popliosemigod/RoboSumo/version.h

// =====================================================================
//  ROBO SUMO - version.h
//  A versao aqui deve casar com a tag do git, senao a placa mente sobre
//  qual firmware esta rodando.
// =====================================================================
#pragma once

#define FW_VERSION "4.0.0"
