popliosemigod/RoboSumo/(commit log)

2026-09-02 chore(repo): estrutura de projeto, convencoes de commit e CI
    Define o esqueleto que o time usa em todos os firmwares: Conventional Commits validados por pre-commit, versionamento por commitizen com a versao refletida em version.h, e um workflow que compila o firmware a cada push e publica o .bin para gravacao por OTA.
    Remove o arquivo placeholder criado junto com o repositorio.
2026-09-02 chore(build): configura PlatformIO mantendo o layout da Arduino IDE
    src_dir aponta para a raiz, entao os dois toolchains compilam a mesma pasta sem duplicar arquivo. A porta serial fica em autodeteccao porque a placa troca de COM ao reconectar.
2026-09-02 feat(config): pinout do ESP32, estados, modos e telemetria
    Pinos escolhidos em blocos fisicamente consecutivos no header da DevKit, para o chicote de cada subsistema sair de pinos vizinhos. Leitura analogica toda no ADC1, porque o ADC2 nao funciona com Wi-Fi ligado.
2026-09-02 feat(core): distribui as tasks entre os dois nucleos do ESP32
    Nucleo 1 fica com o tempo real (guarda de borda prio 6, controle a 200 Hz, leitura dos olhos). Nucleo 0 fica com Wi-Fi, OLED e buzzer. Assim um pedido HTTP travado nao consegue atrasar o freio na borda.
    [RoboSumo.ino]
2026-09-02 feat(motors): duas DRV8833 com os canais em paralelo, uma por lado
    IN1/IN2 comandam OUT1/OUT2 para o par esquerdo e IN3/IN4 comandam OUT3/OUT4 para o direito. Paralelar entrada com saida dobra a corrente do canal (1,5 A viram ~3 A), o que importa porque os dois motores de um lado dividem o mesmo par de saidas. Decaimento lento para ter torque em baixa rotacao.
2026-09-02 feat(sensors): olhos VL53L0X em barramento I2C dedicado
    Os dois modulos nascem no mesmo endereco 0x29, entao o boot liga um de cada vez pelo XSHUT e reendereca o primeiro para 0x30. Presenca e validada lendo o registrador 0xC0 (deve valer 0xEE, Tab. 4 da datasheet) porque o init da biblioteca consegue dar certo falando com o vazio. Barramento separado do OLED: um quadro do display ocupa a linha por ~25 ms e atrasaria a leitura durante a investida.
2026-09-02 feat(brain): maquina de estados com confirmacao anti-ruido do alvo
    Entre ver algo e investir existe o estado TRAVANDO: exige N leituras validas consecutivas e salto menor que jumpCm entre elas. Um eco espurio isolado nunca vira investida.
2026-09-02 feat(face): carinha animada no OLED com expressao por estado
    Olhos desenhados por primitiva grafica, nao por bitmap, para variarem de forma continua. Enum usa prefixo EX_ porque F_LOCK colide com uma macro de fcntl.h e quebrava a compilacao inteira do arquivo.
2026-09-02 feat(sound): tocador RTTTL nao bloqueante no buzzer
    Melodias de dominio publico (Wagner, Rossini, Bizet, Beethoven) mais composicoes proprias. Nao bloqueante porque a musica nao pode roubar tempo da malha de controle.
2026-09-02 feat(web): AP aberto, portal cativo, API JSON e gravacao OTA
    Rede ROBO_SUMO sem senha em 192.168.4.1, com DNS respondendo tudo para o mesmo IP - qualquer endereco digitado cai no painel. softAP antes de softAPConfig, que e a ordem documentada pela Espressif, e modem-sleep desligado porque atrasa beacon e derruba cliente. A partir da primeira gravacao o firmware se atualiza sozinho por OTA, sem PC.
2026-09-02 feat(web): painel de controle embarcado, sem CDN nem internet
    HTML, CSS e JS inteiros em PROGMEM porque a placa serve a pagina offline. Radar dos dois olhos, grafico de PWM e PID, sliders que valem na hora, calibracao do IR e pilotagem manual com watchdog de 700 ms.
2026-09-02 test(diag): painel de bancada no PC lendo a serial
    Le a linha #D chave=valor e mostra o estado de cada componente com verde/vermelho. Funciona sem Wi-Fi, que e justamente quando se precisa dele. Distingue 'barramento vazio' de 'responde mas nao subiu', e sinaliza modulo sem alimentacao em vez de reportar zona segura.
2026-09-02 docs(schematic): esquematico eletrico, pinout e geometria dos sensores
    Cinco folhas: ligacoes de sinal, arvore de alimentacao com terra unico, caminho critico do IR ate o freio, maquina de estados e vista superior do chassi.
2026-09-02 docs: guia de montagem, calibracao e diagnostico pela serial
    Inclui como ler o autoteste do boot, que separa problema de fiacao de problema de calibracao.
2026-09-02 chore(repo): ignora o caderno de sessao CONTEXTO.md
    Notas de bancada, pendencias e armadilhas ja encontradas. Muda a cada sessao e nao interessa a quem clona o repositorio, entao fica fora do git.
2026-09-04 feat: firmware do robo sumo em ESP32 com painel web
    Estado que ja rodou na placa: maquina de estados com contagem, busca,
    travamento anti-ruido, investida com PID e guarda de borda por interrupcao,
    distribuidos em tasks do FreeRTOS entre os dois nucleos. Painel web servido
    pelo proprio AP, calibracao guiada do IR e um conjunto de instrumentos de
    bancada na serial (autoteste, sonda eletrica das linhas I2C, exame dos olhos,
    monitores de 20 Hz e rajada de 1 kHz).
2026-09-04 feat(nano): porte bruto do firmware para Arduino Nano
    Regressao proposital de controlador, para separar problema de fiacao de
    problema de placa mantendo todos os perifericos.
    O ATmega328P impoe quatro mudancas de desenho que estao documentadas no
    codigo e no README da pasta: um unico barramento I2C (OLED divide a linha
    com os olhos, e o desenho e suspenso durante ataque e borda), timers
    compartilhados (PWM cai para 976/490 Hz e tone fica sozinho no Timer2),
    loop unico sem RTOS (a guarda de borda vira interrupcao mais teste no topo
    do loop) e logica de 5 V, que inverte a recomendacao de alimentacao do
    VL53L0X em relacao ao ESP32.
    O OLED nasce desligado por medida: com ele o flash vai a 92,9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
2026-09-04 fix(nano): assume modulo IR de tres fios, sem saida analogica
    Os modulos em uso tem VCC, GND e OUT - nao existe AO. O padrao irSource
    passa a ser 0 (so o pino digital) e a leitura analogica deixa de rodar
    quando ela nao esta selecionada: ler pino solto a 200 Hz so produz numero
    inventado, que foi justamente o que atrapalhou o diagnostico na placa
    anterior.
    Com isso o limiar sai do software e passa a ser o trimpot do modulo.
    Acrescenta a tecla 'p', que imprime o estado dos dois OUT por 60 s para
    ajustar o trimpot olhando o serial, e documenta o procedimento.
    A0 e A1 ficam livres.
2026-09-04 docs(nano): corrige numeracao da secao do modulo IR
    A secao do modulo de tres fios estava numerada 2.1 mas fica dentro da
    secao 1 (pinout), antes da secao 2.
2026-09-04 feat(nano): confirma identidade do VL53L0X pelos registradores de modelo
    O modulo em uso e um CJMCU-53L0X V2 (VCC/GND/SCL/SDA/GPIO1/XSHUT). A
    varredura I2C responde "alguem respondeu em 0x29", mas nao responde se
    esse alguem e mesmo um VL53L0X - modulo trocado, endereco coincidente de
    outro periferico e sensor morto que ainda da ACK aparecem todos iguais.
    Acrescenta a tecla 'i': le os tres registradores de identidade da Tab. 4
    da datasheet (0xC0=0xEE, 0xC1=0xAA, 0xC2=0x10), que existem desde o reset
    e nunca mudam, e diz se confere.
    Documenta tambem o teste de tensao a fazer ANTES de ligar o modulo no
    Nano: com o modulo alimentado sozinho em 5 V, medir SDA contra o GND.
    Perto de 5 V ha conv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
2026-09-04 fix(nano): protege o sensor de 3,3 V e instrumenta o barramento I2C
    O Nano fala em 5 V e o VL53L0X aguenta 3,6 V (Tab. 6). SDA e SCL nunca
    foram o risco - sao dreno aberto, o TWI so puxa para baixo. O risco real
    estava no XSHUT, que era dirigido em push-pull: dezenas de mA de 5 V
    contra o diodo de protecao do sensor. Agora XSHUT e dreno aberto (BAIXO
    para desligar, SOLTO para ligar) e os pull-up internos da Wire, que vao
    para 5 V, sao desligados logo apos o Wire.begin().
    Medido depois da correcao: 3,5 V em repouso nas duas linhas.
    Instrumentos novos, porque o barramento responde em 0x28 e 0x38 em vez
    de 0x29 e 0x3C e as hipoteses pediam medida, nao palpite:
    - u: le o nivel de repouso de A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
2026-09-04 feat(nano): mede o VCC e o GND do modulo pelas entradas A6 e A7
    Modulo sem VDD se alimenta pelos diodos de protecao das linhas de I2C e
    da ACK assim mesmo - foi o que apareceu na bancada, com 0x28 e 0x38
    respondendo ate com XSHUT em BAIXO, condicao em que um VL53L0X
    alimentado esta em standby e nao pode dar ACK nenhum.
    De dentro do barramento essa pergunta nao se responde. A6 e A7 sao
    entradas so analogicas e estavam livres: um jumper do VCC do modulo ate
    A6 e outro do GND ate A7 poem a medida na tecla k. A conta usa VREF de
    4,7 V, que e o AVcc real no USB, em vez dos 5,0 V nominais.
2026-09-04 docs(nano): registra A6 e A7 como sondas de tensao no pinout
    O pinout mandava consultar a secao 1.1 para A0/A1 e dizia que A6 e A7
    estavam livres. A0 e A1 nunca vao receber nada, porque o modulo IR e de
    tres fios, e A6/A7 agora medem o VCC e o GND do modulo ToF pela tecla k.
    Quem monta precisa da tabela inteira valendo, nao de uma remissao.
2026-09-04 feat(esp32): traz do Nano a medida de alimentacao do modulo e o destravamento do I2C
    A regressao para Nano achou a causa raiz dos olhos mudos, e ela nao
    estava em nada que se testou aqui: o GND do modulo VL53L0X fora do terra
    comum, com 0,49 V entre os pinos e o chip se alimentando pelos diodos de
    protecao das linhas de I2C. Meio volt puxa SDA no instante do ACK e nao
    faz mais nada - dai responder em endereco errado, nao devolver
    registrador e ignorar o XSHUT.
    Nenhum teste feito de dentro do barramento separa isso, porque o modulo
    parasitado responde. Por isso vem a tecla k: GPIO 32 e 33 eram o 'AO dos
    modulos IR', entrada que nunca existiu porque o modulo e de tres fios,
    entao estavam sobr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
2026-09-04 feat: tira o botao de armar do projeto e move os olhos para 21/22
    Duas mudancas de hardware que o firmware precisava acompanhar.
    1) O botao de armar deixou de existir. Quem arma e ligar a placa. O
    primeiro guarda que escrevi para isso foi o esp_reset_reason() e ele
    NAO serve: puxar o pino EN e indistinguivel de aplicar energia para o
    RTC, entao todo reset do gravador vinha como ESP_RST_POWERON e o robo
    armava sozinho a cada upload - visto na bancada, com a maquina de
    estados indo para BUSCA e PWM nos motores.
    O criterio que serve e fisico: a BATERIA. Na bancada a placa vive do
    USB e o divisor de VBAT le ~0,2 V; na arena a LiPo 2S esta ligada.
    Arma so acima de VBAT_A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
    [RoboSumo.ino, config.h, sensors.h]
2026-09-04 fix(nano): remove o botao tambem do porte do Nano
    O commit anterior tirou PIN_BTN de pinos.h mas deixou as duas chamadas
    no .cpp, e o ambiente nano parou de compilar. 'De todo o projeto' inclui
    a branch que ja estava integrada.
2026-09-04 fix(esp32): faz OLED e os dois olhos conviverem no barramento 21/22
    Tres dispositivos na mesma linha - 0x29, 0x30 e 0x3C - e dois defeitos
    que so apareceram quando o OLED entrou:
    1) A deteccao de XSHUT perguntava 'o barramento esta VAZIO?'. Isso valia
    quando os olhos tinham barramento proprio. Com o OLED na mesma linha
    ele responde sempre, o firmware lia 0x3C, concluia 'XSHUT nao esta
    ligado' e caia em modo caolho com dois olhos bons na mesa. A pergunta
    certa nunca foi 'ha alguem no barramento' e sim 'ha um VL53L0X': quem
    responde isso e o registrador 0xC0, que vale 0xEE em todo VL53L0X
    (Tab. 4) e nao existe no SSD1306.
    2) O init() do sensor falhava de forma intermitente.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
    [sensors.h]
2026-09-08 fix(esp32): decide borda so pelo pino digital e mede a tensao que chega nele
    Tres correcoes no caminho do IR, todas vindas da bancada.
    irSource nascia 1 (so ADC), herdado de quando se achava que os modulos
    tinham saida analogica. Eles sao de tres fios, e os GPIO 32/33 que eram
    o 'AO' viraram sondas do ToF - o robo estava declarando BORDA a partir da
    alimentacao de outro sensor. Agora nasce 0, e o caminho analogico do IR
    saiu de pollIrAnalog e do autoteste.
    O autoteste passa a medir a TENSAO em GPIO 34 e 35, que sao ADC1. Num
    pino sem pull-up interno o digitalRead sozinho nao separa 'sensor
    disparado' de 'fio partido' - os dois leem BAIXO. A tensao separa:
    ~3,1 V com digital BAIXO acusa o p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
    [config.h, sensors.h]
2026-09-08 feat(regras): receptor IR do juiz e limpeza do hardware que nao existe
    Duas frentes, e a segunda e a que estava mentindo na documentacao.
    1) O robo passa a obedecer o regulamento do Sumo Tech Fight.
    O Artigo 18 torna obrigatorio um receptor de 950 nm / 38 kHz para os
    comandos do arbitro. Ele entra no GPIO 32 e traz junto a maquina de
    estados do Artigo 33, no arquivo juiz.h:
    A (0x0C) -> READY : pronto e IMOVEL
    B (0x18) -> START : comeca a luta, so valendo a partir de READY
    C (0x5E) -> STOP : parada DEFINITIVA
    O STOP e o ponto que o regulamento detalha mais: 'ao receber o sinal de
    Stop, seu robo nao deve poder fazer mais nada antes de ser reiniciado'.
    Nao e pausa, e trava - por isso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
2026-09-18 feat!: v2 com eletronica simplificada (1 IR, 1 ultrassom, 2 pontes H)
    Troca o ESP32 DevKit V1 pelo ESP32-C3 Mini e reduz a eletronica aos
    componentes que se comportaram na bancada. A logica de combate e a
    mesma; o que mudou foi o hardware embaixo dela.
    - olhos: 2x VL53L0X -> 1x HC-SR04, com o ECHO medido por interrupcao.
    pulseIn() seguraria a CPU por ate 38 ms por leitura, e numa placa de
    nucleo unico isso disputaria tempo com a guarda de borda
    - borda: 2 sensores IR -> 1, montado na frente. O giro de fuga alterna
    de lado a cada salvamento, para nao colher a mesma borda de novo
    - as tasks deixam de ser fixadas por nucleo: o C3 tem um nucleo so, e
    xTaskCreatePinnedToCore(..., 1, ...)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
    [RoboSumo.ino, brain.h, config.h, page.h, sensors.h, version.h, web.h]
2026-09-18 fix(docs): tira a bateria do pino 5V da ESP32 no esquematico
    O desenho mostrava a bateria de 7,4 V alimentando o pino 5V do C3 Mini.
    O regulador da placa (ME6211) aceita no maximo ~6,5 V, e uma 2S entrega
    8,4 V carregada - ligar assim queima o regulador.
    A especificacao da montagem tambem nunca pediu isso: a bateria alimenta
    o VM das pontes, e so. Nesta configuracao de teste a ESP32 vai pelo USB,
    e o 3V3 dela alimenta os sensores.
    Fica anotado no esquematico e no README que rodar sem cabo exige um
    step-down de 5 V entre a bateria e esse pino.
2026-09-22 feat!: v3 com eletronica enxuta (TB6612FNG, 2 motores, IR analogico)
    Troca a montagem de 4 motores e 2 pontes DRV8833 por 2 motores numa
    unica TB6612FNG, e passa a ler a borda pela saida ANALOGICA do IR.
    - ponte: os 7 pinos da TB6612FNG nao cabem nos 10 GPIOs uteis do C3
    SuperMini (7 + TRIG + ECHO + IR + receptor = 11). PWMA/PWMB vao
    jumpeados em 3V3 e o PWM e aplicado nos proprios AIN/BIN: pela
    tabela-verdade da datasheet isso alterna CW <-> short brake, que e
    decaimento lento e da mais torque parado. Cai para 5 pinos.
    - borda: le o AO no ADC1 em vez do DO. O DO ja vem comparado contra o
    trimpot do modulo, e limiar que mora num parafuso nao da para
    versionar nem ajustar por con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
    [RoboSumo.ino, brain.h, config.h, motors.h, sensors.h, version.h, web.h]
2026-09-22 feat(web): volta a pilotagem manual e o seletor de modos
    O painel da v2 tinha ficado so com start/stop. Volta o acionamento dos
    motores e a troca de modo, adaptados para duas rodas: frente, re, girar
    no proprio eixo para cada lado e parar - que e tudo o que dois motores
    permitem.
    A pilotagem reenvia a direcao a cada 300 ms enquanto o botao esta
    pressionado. Nao e desperdicio: e o que mantem vivo o corte por silencio
    do ST_MANUAL, entao se a aba fechar ou o Wi-Fi cair com o robo andando
    ele para sozinho em 700 ms em vez de atravessar a mesa.
    Segue sem ajuste de parametro na tela.
2026-09-22 docs: pinagem da v3, divisores de tensao e notas de alimentacao
    README com a tabela GPIO -> componente (marcando o pino de ADC), a
    pinagem completa dos 24 pinos da TB6612FNG e o esquematico redesenhado.
    Os dois divisores ganharam esquema proprio, com os valores e a conta:
    ECHO 1k / 2k -> 5 V x 2k/3k = 3,33 V (max. do GPIO: 3,6 V)
    IR AO 10k / 10k -> 5 V x 10k/20k = 2,50 V (ADC satura perto de 3,1 V)
    Dois avisos de montagem que saem da datasheet e nao eram obvios:
    - VCC da ponte vai em 3,3 V, nao em 5 V. A Toshiba da VIH = VCC x 0,7,
    entao com VCC em 5 V o nivel ALTO exigiria 3,5 V - acima do que a C3
    entrega. Com 3,3 V o limiar cai para 2,31 V e sobra margem.
    - o step-down de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
2026-09-22 docs: CHANGELOG da v3 e instrucoes do projeto atualizadas
    O CLAUDE.md ainda descrevia a montagem da v2 - 4 motores, duas DRV8833 e
    borda por pino digital. Passa a descrever o hardware que existe, e ganha
    as armadilhas novas: VCC da ponte em 3,3 V, bateria fora da ESP32 e o
    ADC1 escolhido porque o ADC2 nao funciona com o Wi-Fi ligado.
2026-09-22 feat!: v4 troca a TB6612FNG por um L298N micro
    Mesma topologia de 2 rodas e a mesma pinagem: so muda a ponte. IN1..IN4
    seguem nos GPIO 3/4/5/6 e o antigo STBY vira ENA+ENB amarrados no 7.
    Duas coisas da tabela-verdade do L298N que mandaram no codigo:
    - o PWM continua nos pinos IN, nao no EN. Com EN em ALTO, chavear IN2
    enquanto IN1 fica em ALTO alterna girar <-> freio, que e decaimento
    lento. PWM no EN alternaria entre girar e roda livre (decaimento
    rapido), justamente o que nao interessa num sumo.
    - com EN em ALTO o L298N NAO tem roda livre: IN1=IN2 freia, seja em
    ALTO ou em BAIXO. Por isso Mot::coast() passou a baixar o EN em vez
    de so zerar os PWM - antes ele deixaria a ponte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
2026-09-22 refactor(pinout): ponte H inteira na fileira A, num conector so
    Rearranja os pinos para o modulo L298N encaixar de uma vez na extension
    board, em vez de sair fio por fio para as duas bordas da placa.
    Fileira A: 5 6 7 [8] [9] 10 20 21
    IN1 IN2 IN3 - - IN4 EN receptor
    Fileira B: 0 1 [2] 3 4
    IR livre - TRIG ECHO
    IN1..IN4 viram uma barra de 6 vias cobrindo 5..10, com as posicoes do 8
    e do 9 SEM CONTATO. Elas ficam vazias porque sao strapping - o 9 e o
    BOOT, e se algo o puxar para baixo no reset a placa entra em modo de
    gravacao e o firmware nunca roda.
    Nao existe corrida de QUATRO pinos uteis seguidos nesta placa: o 2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
    [config.h, sensors.h]
2026-09-22 docs: pinagem de encaixe, L298N e o pull-down do EN
    README e esquematico refeitos para o L298N e para a pinagem nova, com as
    duas fileiras desenhadas como elas ficam na extension board e o conector
    de 6 vias marcado.
    Tres notas de montagem que saem da datasheet:
    - Vss (logica) do L298N quer 4,5 a 7 V, entao 5 V e nao 3,3 V. Mas as
    ENTRADAS pedem so Vih >= 2,3 V, e os 3,3 V da C3 comandam a ponte
    direto, sem level shifter.
    - pull-down de 10k no EN, pelo intervalo entre ligar e o setup() rodar.
    - o L298N derruba ~2 V na ponte: dos 7,8 V o motor ve perto de 5,8 V, e
    o resto vira calor.
2026-09-22 chore(git): ignora o .vscode inteiro
    As tres excecoes (extensions.json, settings.json, launch.json) apontavam
    para arquivos que sairam na limpeza do repositorio. Com elas no lugar, o
    editor recriava esses arquivos e eles voltavam a aparecer como nao
    rastreados a cada `git status`.
